chatwithllm/GroundHog/media/probe/vf_gnd.png

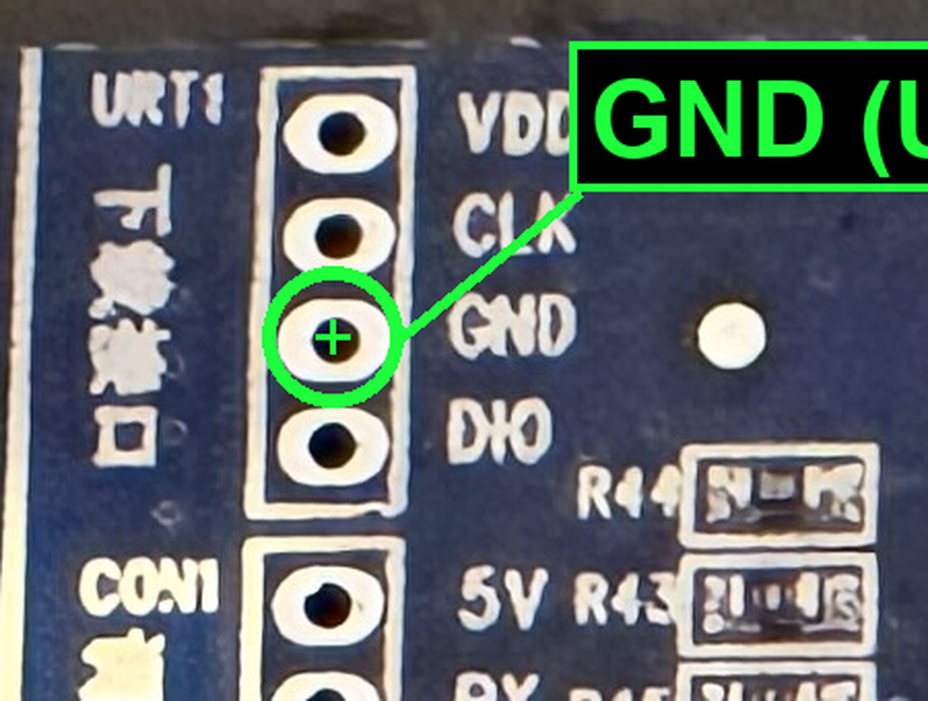
media/probe/vf_gnd.png
