chatwithllm/GroundHog/media/probe/vf_cap2.png

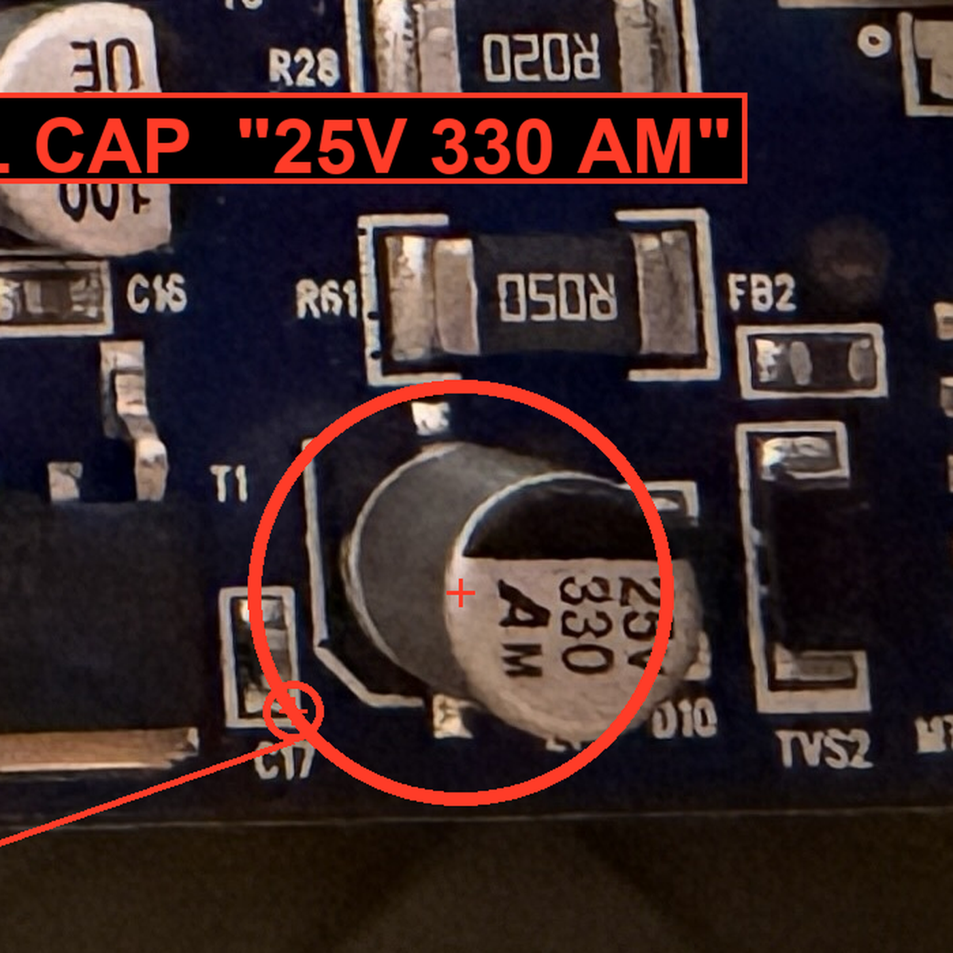
media/probe/vf_cap2.png
