chatwithllm/GroundHog/media/diagrams/arch_handdrawn.png

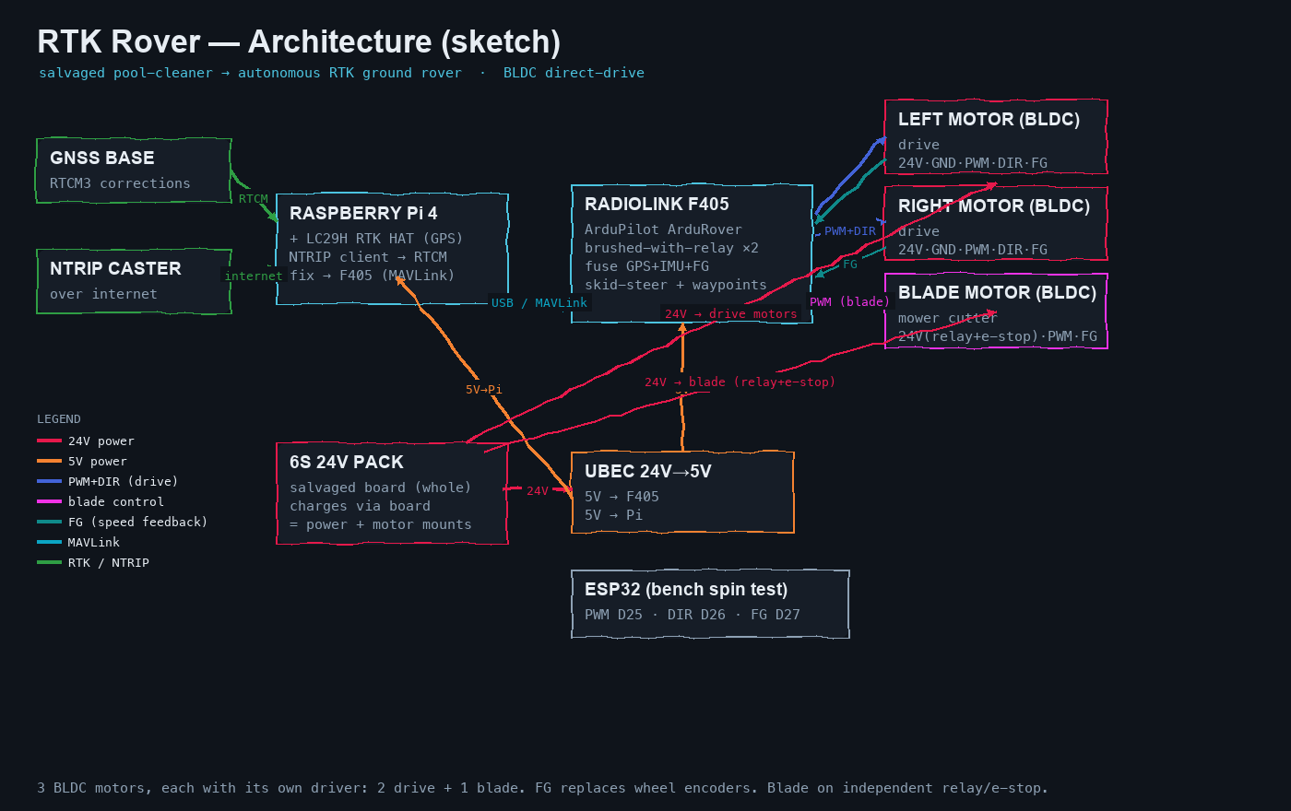
media/diagrams/arch_handdrawn.png
