chatwithllm/GroundHog/media/diagrams/complete_flow.png

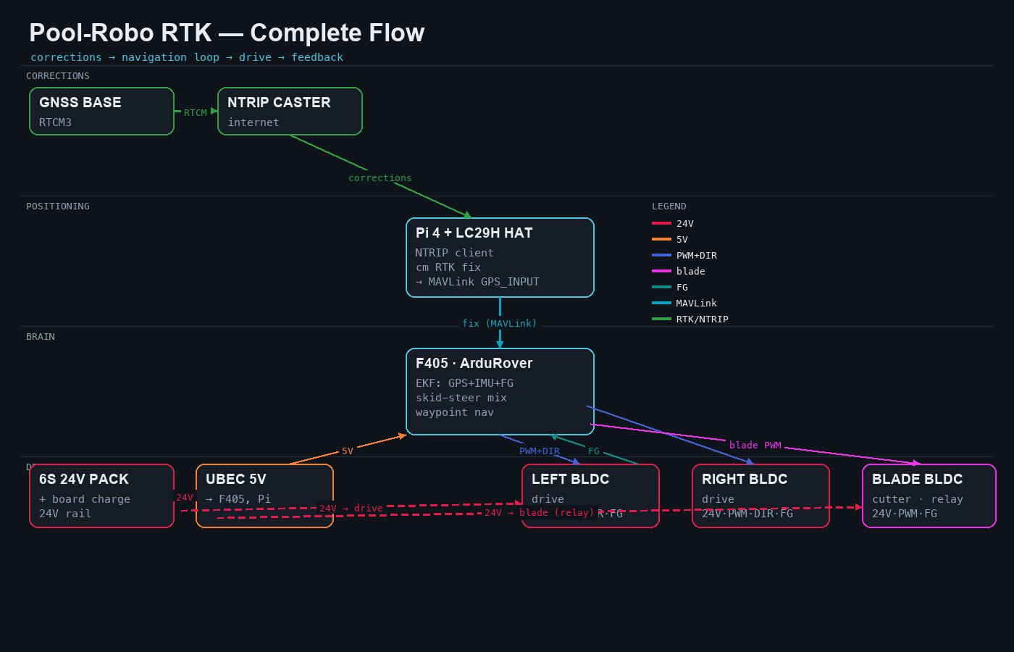
media/diagrams/complete_flow.png
