chatwithllm/GroundHog/media/diagrams/pinout.png

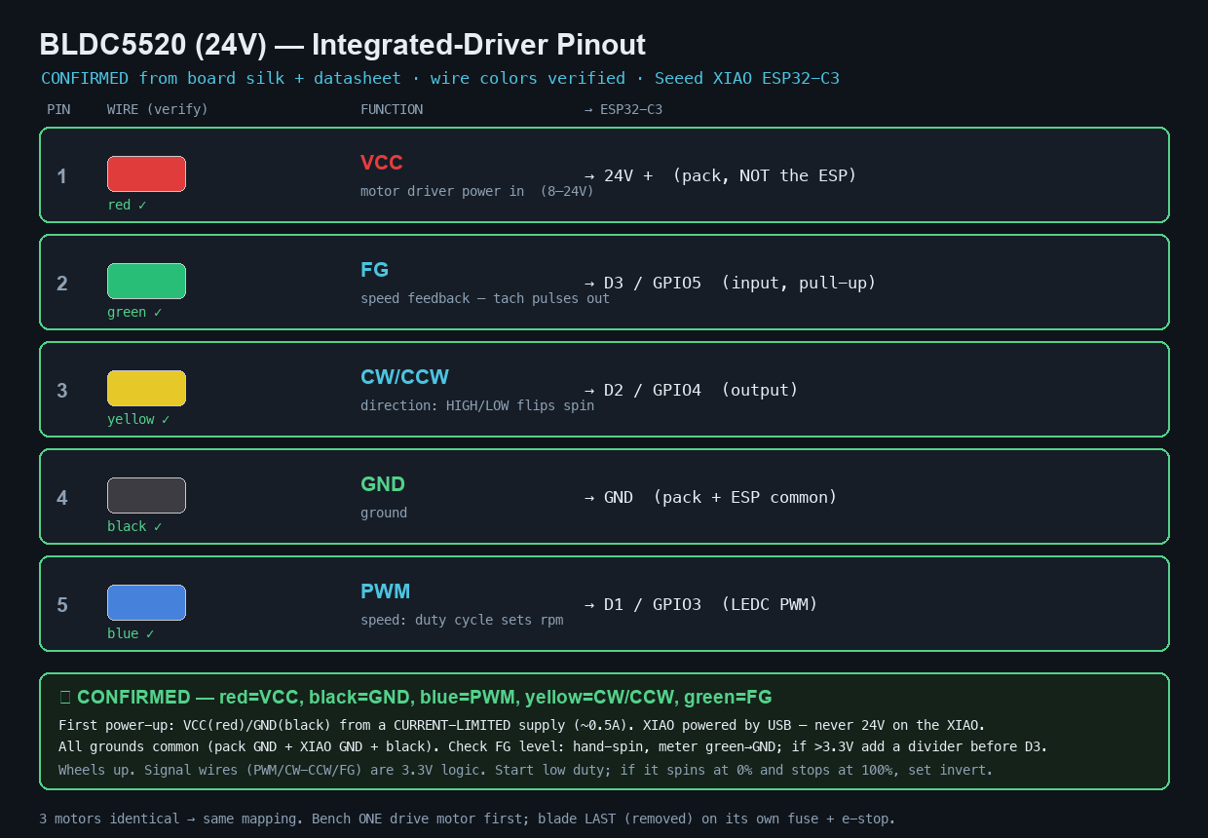
media/diagrams/pinout.png
