chatwithllm/GroundHog/media/probe/rail_cap_zoom2.png

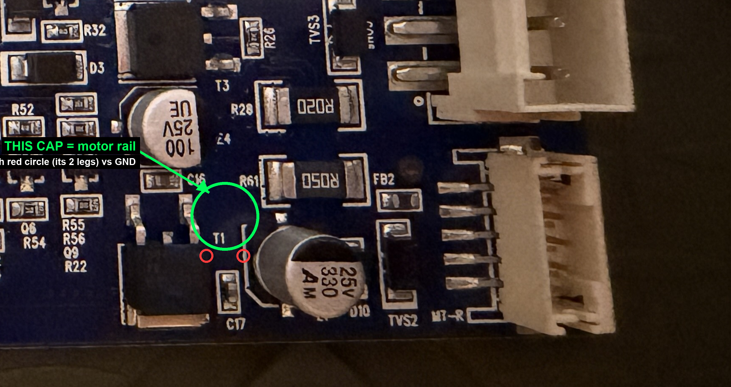
media/probe/rail_cap_zoom2.png
