chatwithllm/GroundHog/media/probe/vf_batt2.png

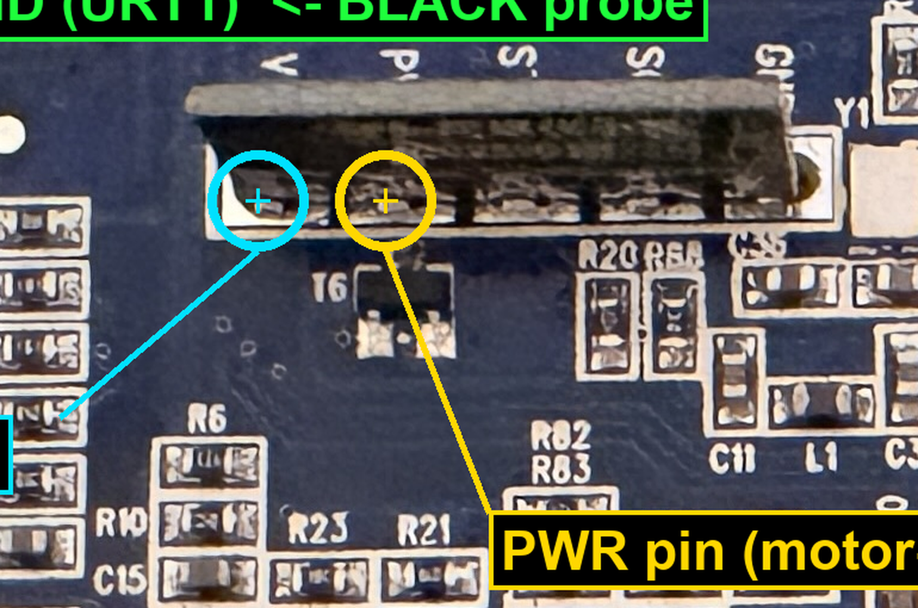
media/probe/vf_batt2.png
