chatwithllm/GroundHog/media/diagrams/c6_2motor_wiring.png

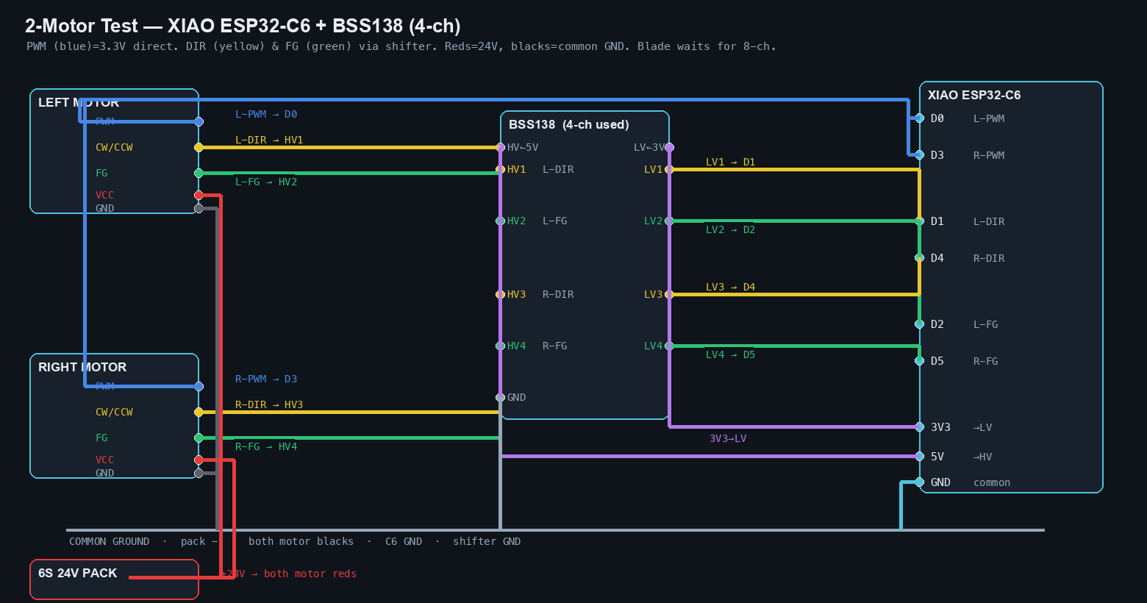
media/diagrams/c6_2motor_wiring.png
