chatwithllm/GroundHog/media/diagrams/c6_wiring.png

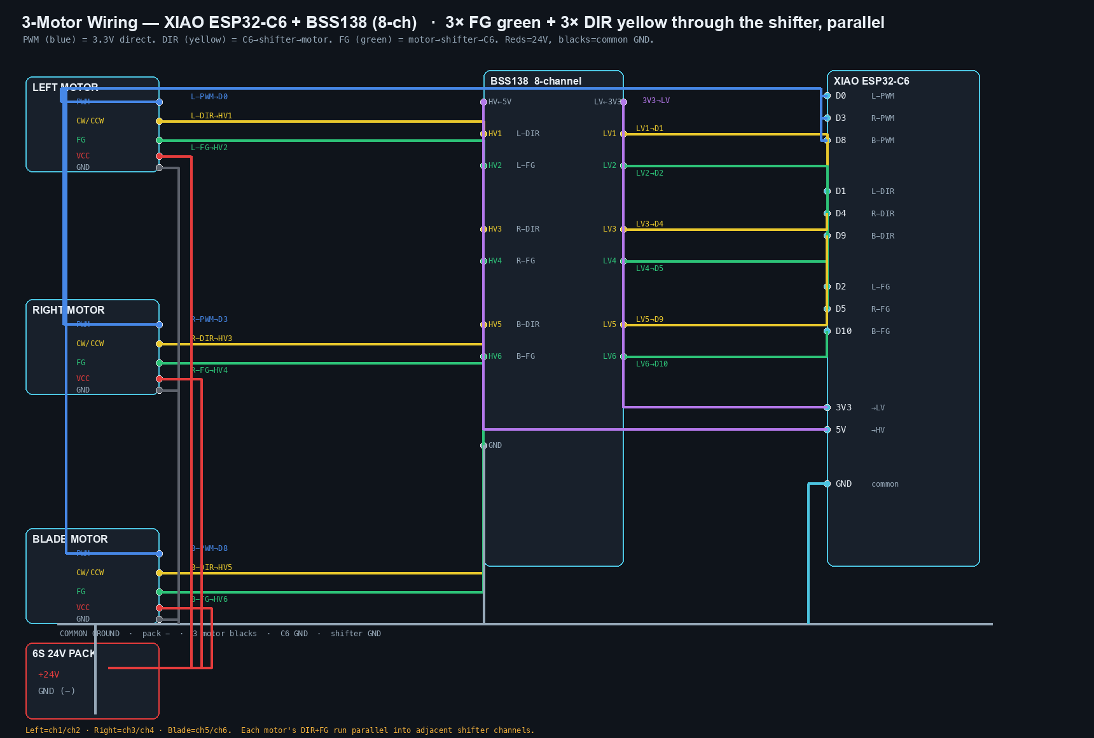
media/diagrams/c6_wiring.png
