chatwithllm/GroundHog/media/diagrams/esp8266_wiring.png

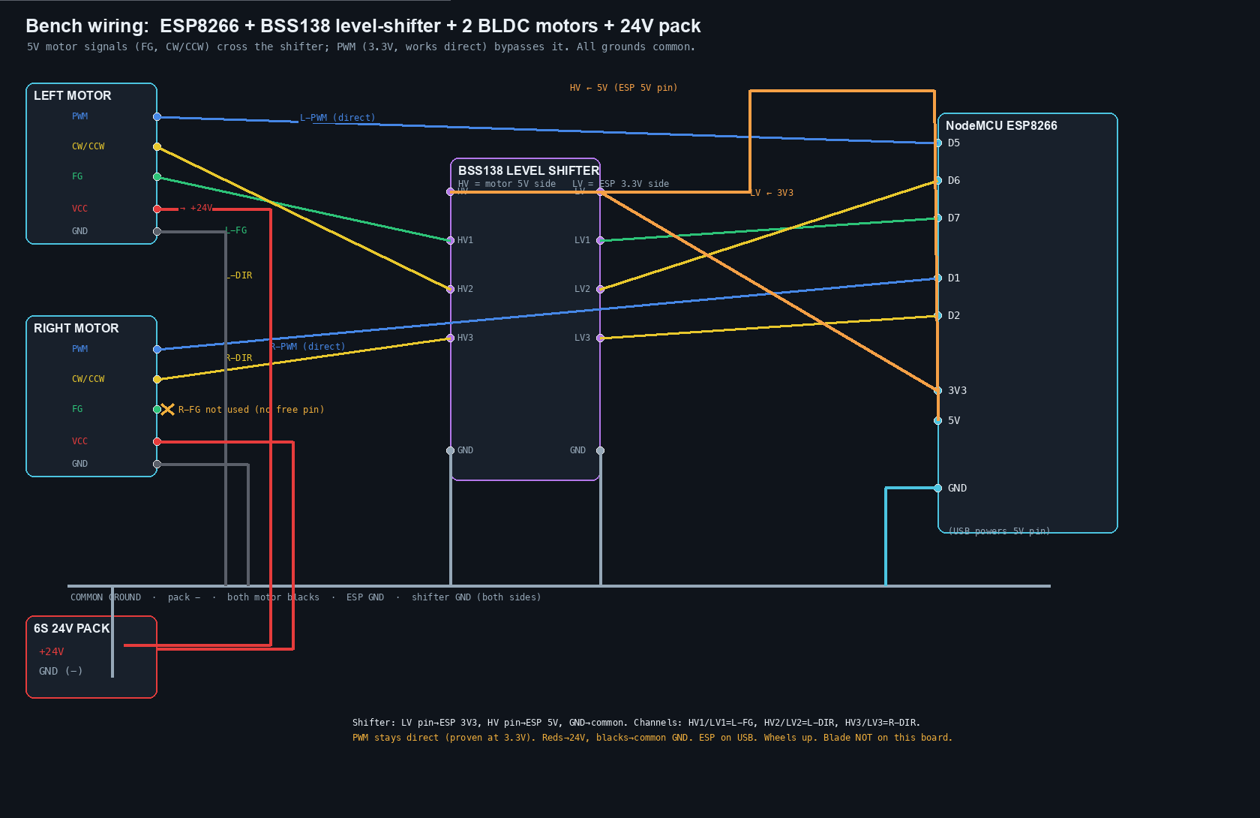
media/diagrams/esp8266_wiring.png
