chatwithllm/GroundHog/(commit log)

2026-08-17 Initial commit: Groundhog — autonomous RTK ground robot platform
    Tracked, RTK-precise ground robot with a modular ESP32 motor interface,
    Radiolink F405/ArduRover brain, and Raspberry Pi + LC29H RTK companion.
    Firmware (ESPHome + Arduino), design specs, interactive wiring planner,
    and bench diagnostics. Secrets excluded via .gitignore.
2026-08-17 docs: add component knowledge-base scaffold + link from planner
    Field-service KB (media/diagrams/component_kb.html): one self-documenting
    card per replaceable component — Motherboard/SP5, Motor ESP (C6→S3),
    Radiolink F405, Companion Pi+LC29H, FlySky RC. Each carries specs, wiring,
    reflash procedure, and replace gotchas. Textual content populated from the
    working bench setup; image slots are placeholders keyed to filenames under
    media/diagrams/. Wiring planner gets a 'Component KB' link (Both/linked).
2026-08-17 docs: add Intel RealSense D455 depth camera to planner + KB
    Swap the placeholder OBSBOT PTZ tile for the RealSense D455 (depth+RGB+IMU
    over USB3, now active). Add a 6th component KB card: specs, stream nodes,
    librealsense source-build setup, and gotchas (USB3 required, no trixie apt
    pkg / py3.13 wheel, Pi 4 SLAM limits).
2026-08-17 feat: add D455 perception module (depth + obstacle + person detection)
    pyrealsense2 depth server (perception/depthcam.py): RGB/depth/IR MJPEG stream
    with web control panel; center+nearest distance and obstacle flag; depth-blob
    near-object box (works in the dark); AI person detection (YOLOv8n COCO via
    onnxruntime, boxes fused with depth for distance); crosshair + flat-wall
    plane-fit accuracy tools. README covers librealsense-from-source build,
    venv+onnxruntime, model fetch, udev rules, and the systemd run-as-root
    service. KB D455 card -> Working. Model files gitignored (fetch per README).
2026-08-17 feat(nav): NMEA parser + fix-mapping + GPS_INPUT builder (TDD)
    [rtk_gps_bridge.py, test_rtk_gps_bridge.py]
2026-08-17 feat(nav): bridge main loop + service + param setter; router by-id + fixes
    - rtk_gps_bridge.py: main() tails live-nmea.log -> GPS_INPUT -> router (udpout:14551)
    - service runs as npalakurla (pymavlink lives in user-site, systemd-as-root cannot see it)
    - router Device -> stable /dev/serial/by-id path (ttyACMx shuffles on F405 reboot)
    - param setter uses GPS1_TYPE (Rover 4.7 renamed GPS_TYPE)
    KNOWN BLOCKER: F405 will not ingest GPS_INPUT (EKF3 'waiting for GPS config
    data', GPS_RAW_INT stays 0) even direct-to-serial with valid GPS week + ignore
    flags. Suspected MAV GPS backend stripped on the 1MB-flash build (same class of
    stripping as proximity/OA). Escalating for an architecture decision.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
    [rtk_gps_bridge.py, set_ardupilot_gps.py]
